Monash-BoSL/microBoSL/README.md

# microBoSL
This is a repository for the microBoSL motor controller
