Monash-BoSL/microBoSL/Design/RTC Resistor Supply Calulations.xlsx

V | 10 | 7.2 | 8.4
R1 | 4700000
R2 | 4700000 | RRTCnx | IRTC
RRTC | 2819075.403 | 3816758.102 | 9.672909972e-07
I | 1.547475276e-06 | A
VRTC | 2.726866202 | V
IRTC | 9.672909777e-07 | A
V | I | VRTC | IRTC
6 | 9.44737906e-07 | 1.559731842 | 6.128800673e-07
6.5 | 1.002218166e-06 | 1.789574621 | 6.214576082e-07
7 | 1.065080968e-06 | 1.994119452 | 6.40800233e-07
7.5 | 1.132012105e-06 | 2.179543109 | 6.682795283e-07
8 | 1.202206286e-06 | 2.349630456 | 7.022849123e-07
8.5 | 1.275118562e-06 | 2.506942757 | 7.417264865e-07
9 | 1.350353023e-06 | 2.653340792 | 7.858124291e-07
9.5 | 1.427606772e-06 | 2.790248174 | 8.339369474e-07
10 | 1.515892943e-06 | 2.875303169 | 9.041263109e-07
