Monash-BoSL/microBoSL/EDA/microBoSL BOM rev 0.3.0R.xlsx

Part Number | Package Size / Type | Schematic Designator | Component | Notes | Value | QTY per board | Unit Price | Total Price | Supplier
CL21A225KAFNNNE | `0850 | C1 | SMD Capacitor |  | 2.2 µF | 1 |  |  | https://au.mouser.com/ProductDetail/Samsung-Electro-Mechanics/CL21A225KAFNNNE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
C0402C220J8HACTU | `0402 | C2, C3 | SMD Capacitor |  | 22 pF | 2 |  |  | https://au.mouser.com/ProductDetail/KEMET/C0402C220J8HACTU?qs=W0yvOO0ixfGTPsKyhb5TPg%3D%3D
C0402C103K3RACTU | `0402 | C4, C5, C6, C7, C9, C16 | SMD Capacitor |  | 100 nF | 6 |  |  | https://au.mouser.com/ProductDetail/KEMET/C0402C103K3RACTU?qs=A9KPa1hU2BRD%252BYWIRO5N9g%3D%3D
C0402C101K3RACAUTO | `0402 | C8 | SMD Capacitor |  | 100 pF | 1 |  |  | https://au.mouser.com/ProductDetail/KEMET/C0402C101K3RACAUTO?qs=DuoOggApuK%2FQ6tIpLsntww%3D%3D
CBR04C519C5GAC | `0402 | C10, C12 | SMD Capacitor |  | 5.1 pF | 2 |  |  | https://au.mouser.com/ProductDetail/KEMET/CBR04C519C5GAC?qs=3SGS%2FGl3GGyNP7GoYF0kaA%3D%3D
C0402C689C5HACTU | `0402 | C11 | SMD Capacitor |  | 6.8 pF | 1 |  |  | https://au.mouser.com/ProductDetail/KEMET/C0402C689C5HACTU?qs=W0yvOO0ixfGXwgbtOD1z1Q%3D%3D
C0402C120J5HACTU | `0402 | C13 | SMD Capacitor |  | 12 pF | 1 |  |  | https://au.mouser.com/ProductDetail/KEMET/C0402C120J5HACTU?qs=W0yvOO0ixfEXT14Jx8aNmg%3D%3D
C0402C180J5GAC | `0402 | C14 | SMD Capacitor |  | 18 pF | 1 |  |  | https://au.mouser.com/ProductDetail/KEMET/C0402C180J5GAC?qs=cr8T4Ugre44OlnkcWxtp5A%3D%3D
CBR04C919B5GAC | `0402 | C15 | SMD Capacitor |  | 9.1 pF | 1 |  |  | https://au.mouser.com/ProductDetail/KEMET/CBR04C919B5GAC?qs=bKFmlxG1yYCTvjDGLjuaMw%3D%3D
C0402C150J4GACAUTO | `0402 | C17, C18 | SMD Capacitor |  | 15 pF | 2 |  |  | https://au.mouser.com/ProductDetail/KEMET/C0402C150J4GACAUTO?qs=hzBznG4dWXWlynvDG1YShw%3D%3D
150060RS55040 | `0603 | D1 | LED |  |  |  |  |  | https://au.mouser.com/ProductDetail/Wurth-Elektronik/150060RS55040?qs=8Aam6%252B7C6HHnMZFlrlTntA==
150060GS55040 | `0603 | D2 | LED |  |  |  |  |  | https://au.mouser.com/ProductDetail/Wurth-Elektronik/150060GS55040?qs=fAHHVMwC%252Bbhr5Aln2oA6Nw==
150060YS55040 | `0603 | D3 | LED |  |  |  |  |  | https://au.mouser.com/ProductDetail/Wurth-Elektronik/150060YS55040?qs=8Aam6%252B7C6HFRKfAQmHjhWw==
CUS08F30H3F | SOD-323 | D4 | Diode |  |  | 1 |  |  | https://au.mouser.com/ProductDetail/Toshiba/CUS08F30H3F
0685t1000-01 | `1206 | F1 | Fuse |  | 1A | 1 |  |  | https://au.element14.com/bel-fuse/0685t1000-01/fuse-smd-1a-slow-blow-1206/dp/2848605
105133-0001 |  | J8 | Micro USB Connectior |  |  | 1 |  |  | https://au.mouser.com/ProductDetail/Molex/105133-0001?qs=nmDtFRDcSi58kjLMHJLbzg==
7447840222G | `0402 | L1 | SMD Inductor |  | 220 nH | 1 |  |  | https://au.mouser.com/ProductDetail/Wurth-Elektronik/7447840222G?qs=aP1CjGhiNiGA2042fRI%2FsQ%3D%3D
`7847804680 | `0402 | L2 | SMD Inductor |  | 68 nH | 1 |  |  | https://au.mouser.com/ProductDetail/Wurth-Elektronik/7847804680?qs=QNEnbhJQKvb%252BwQpFKz64DQ%3D%3D
LQW15AN24NH00D | `0402 | L3 | SMD Inductor |  | 24 nH | 1 |  |  | https://au.mouser.com/ProductDetail/Murata-Electronics/LQW15AN24NH00D?qs=K6aI6PsrKE05Leu4Qv5MjA%3D%3D
`7847804270 | `0402 | L4 | SMD Inductor |  | 27 nH | 1 |  |  | https://au.mouser.com/ProductDetail/Wurth-Elektronik/7847804270?qs=QNEnbhJQKvaAR9QxS1FEoQ%3D%3D
7447840112G | `0402 | L5, L6 | SMD Inductor |  | 12 nH | 2 |  |  | https://au.mouser.com/ProductDetail/Wurth-Elektronik/7447840112G?qs=aP1CjGhiNiE%252BdejqttafAg%3D%3D
DMP2165UW-7 | SOT-323 | Q1, Q2 | MOSFET |  |  | 2 |  |  | https://au.mouser.com/ProductDetail/Diodes-Incorporated/DMP2165UW-7?qs=y6ZabgHbY%252ByvCNbAJzQtdQ==
ERJ-2RKF1002X | `0402 | R1, R2, R3, R5, R9, R10 | SMD Resistor |  | 10 kΩ | 6 |  |  | https://au.mouser.com/ProductDetail/Panasonic/ERJ-2RKF1002X?qs=sGAEpiMZZMvdGkrng054t8ugkoYZivkgyTBPpPnizTM%3D
CRCW04024M70FKEDC | `0402 | R4, R11, R12 | SMD Resistor |  | 4.7 MΩ | 3 |  |  | https://au.mouser.com/ProductDetail/Vishay-Dale/CRCW04024M70FKEDC
ERJ-2GEJ332X | `0402 | R6, R7, R8 | SMD Resistor |  | 3.3 kΩ | 3 |  |  | https://au.mouser.com/ProductDetail/Panasonic/ERJ-2GEJ332X?qs=sGAEpiMZZMvdGkrng054t8AJgcdMkx7xqgoPH9w2Bpk%3D
EG1215AA |  | SW2 | SPDT Switch |  | EG1215AA | 1 |  |  | https://www.digikey.com/en/products/detail/e-switch/EG1215AA/9559277
TPS709A33DBVT | SOT-323 | U1 | LDO |  | TPS709A33DBVT | 1 |  |  | https://au.mouser.com/ProductDetail/Texas-Instruments/TPS709A33DBVT?qs=9yI11AV48ZQgL37ZcAbPUA==
ZXBM5210-S-13 | SOIC-8 | U2 | H-Bridge |  | ZXBM5210-S | 1 |  |  | https://au.mouser.com/ProductDetail/Diodes-Incorporated/ZXBM5210-S-13?qs=98WN/nWUQiQlr91Z1/DTeg==
MCP7940NT-I-MNY | DFN-8 | U3 | RTC |  | MCP7940N-xMNY | 1 |  |  | https://au.mouser.com/ProductDetail/Microchip-Technology/MCP7940NT-I-MNY?qs=o%2FJGMiCJeCOibhksvba4EQ%3D%3D
ATMEGA328P-MMH | QFN-28 | U4 | MCU |  | ATmega328-MMH | 1 |  |  | https://au.mouser.com/ProductDetail/Microchip-Technology-Atmel/ATMEGA328P-MMH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
74HC126PW-Q100J | TSSOP-14 | U6 | Tri-state buffer |  | 74HC126PW-Q100 | 1 |  |  | https://au.mouser.com/ProductDetail/Nexperia/74HC126PW-Q100J
FT232RQ-REEL | QFN-32 | U7 | USB-TTL |  | FT232RQ | 1 |  |  | https://au.mouser.com/ProductDetail/FTDI/FT232RQ-REEL?qs=D1%2FPMqvA103VVcOzf7gfmQ%3D%3D
SI4463-C2A-GMR | QFN-20 | U8 | Radio |  | Si4463 | 1 |  |  | https://au.mouser.com/ProductDetail/Silicon-Labs/SI4463-C2A-GMR?qs=p9T7GgSe1IH7yXWv7w1wyw%3D%3D
520-80-18-33-JGN-TR3 |  | Y1 | Crystal |  | 8MHz | 1 |  |  | https://au.mouser.com/ProductDetail/ECS/ECS-80-18-33-JGN-TR3?qs=e8oIoAS2J1TSsZ53cMqlyQ%3D%3D
LFXTAL050789Reel |  | Y2 | Crystal |  | 32.768 kHz | 1 |  |  | https://au.mouser.com/ProductDetail/IQD/LFXTAL050789Reel
ABM8AIG-30.000MHz-12-D2Z-T |  | Y3 | Crystal |  | 30 MHz | 1 |  |  | https://au.mouser.com/ProductDetail/ABRACON/ABM8AIG-30.000MHz-12-D2Z-T?qs=0lSvoLzn4L93%2F944hWTYSg%3D%3D
