Monash-BoSL/microBoSL/EDA/microBoSL schematic rev 0.3.0R.pdf

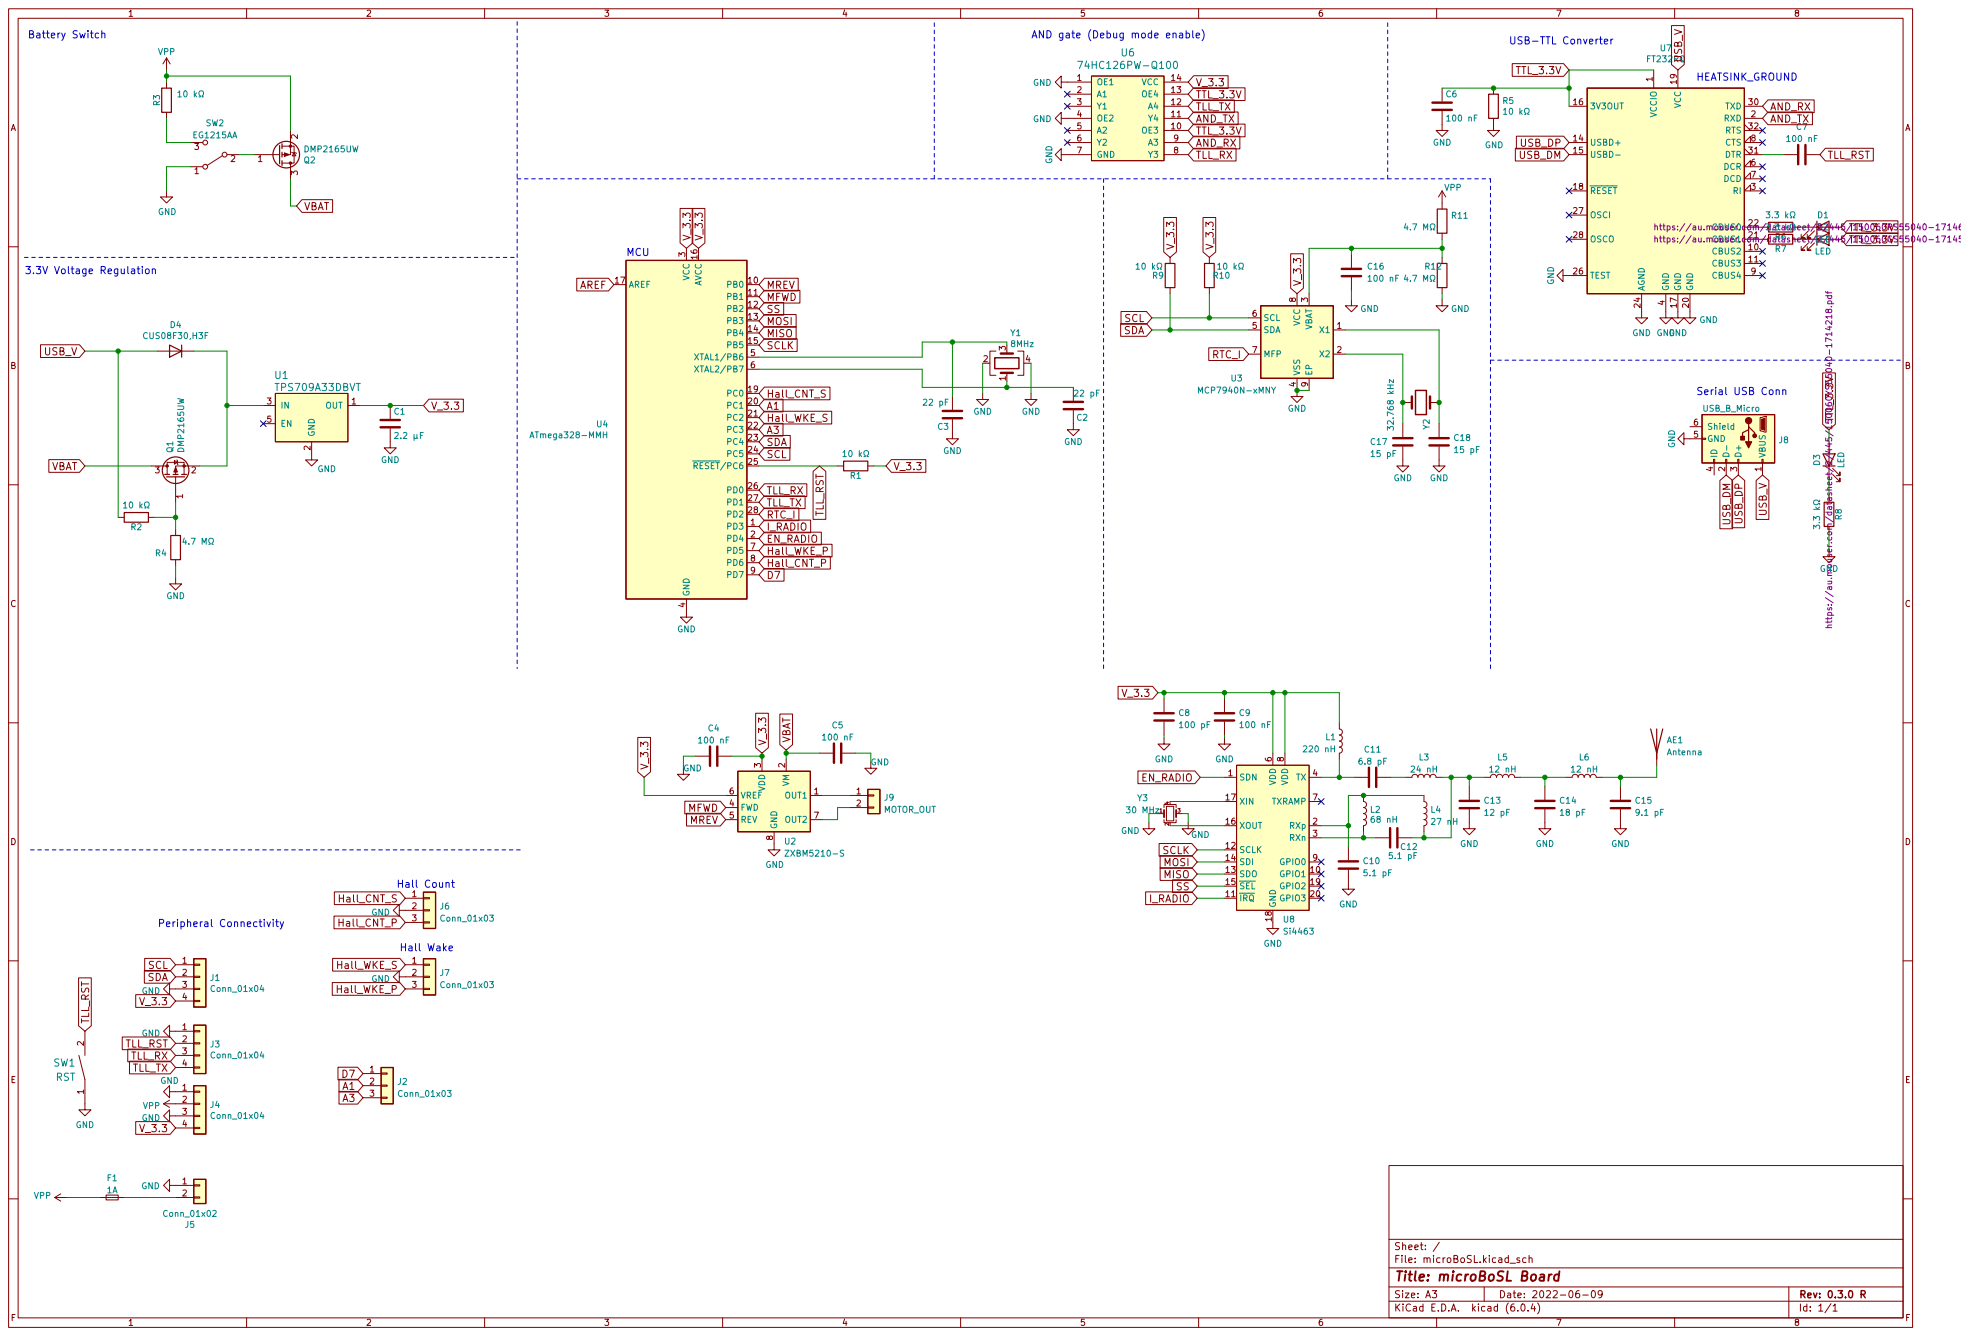
[picture p1: page 1]

https://au.mouser.com/datasheet/2/445/150060RS55040-1714619.pdf

21 CBUS0
https://au.mouser.com/datasheet/2/445/150060GS55040-1714515.pdf R6
10 CBUS3

4 SDA 5 SCL 6 MFP 7 VCC

3 FWD 4 REV 5 VREF 6 OUT2 7 GND

Hall Wake Peripheral Connectivity

Id: 1/1 Title: microBoSL Board
