Monash-BoSL/microBoSL/(list of files, drawings)

Other design files:
EDA/EDA/microBoSL.dsn
