Monash-BoSL/microBoSL/EDA/EDA/microBoSL.kicad_pcb

## KiCad design EDA/EDA/microBoSL.kicad_pcb (2022-06-20)

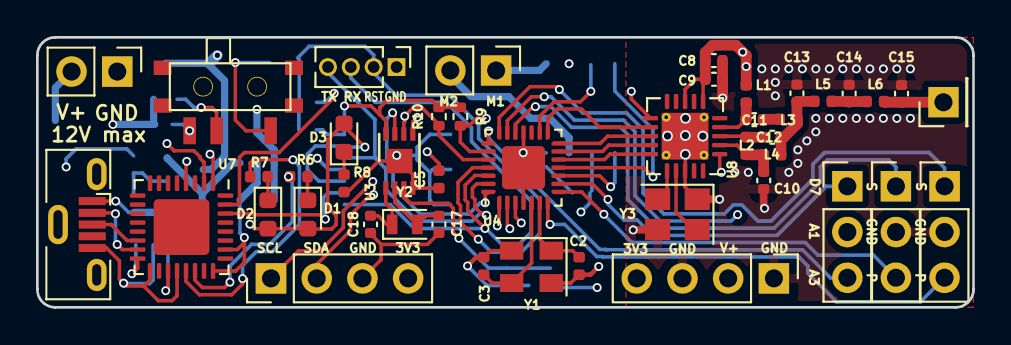
[picture p2: board microBoSL.kicad_pcb from above]

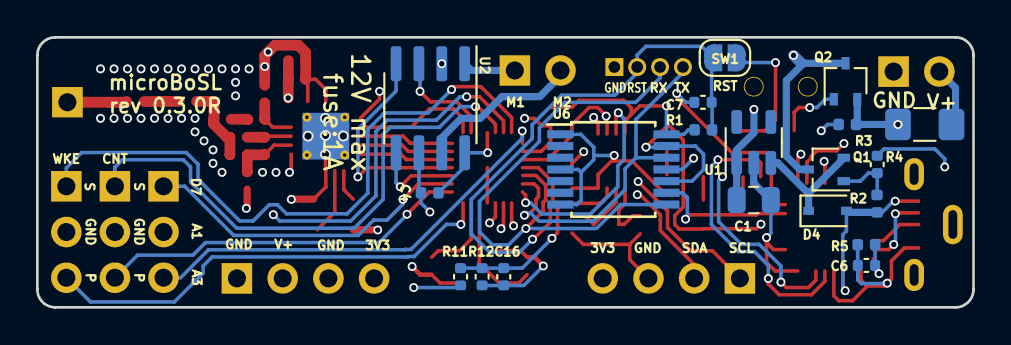
[picture p3: board microBoSL.kicad_pcb from below]

Board: 4 copper layers, 52.0 x 15.0 mm, 65 parts (20 on the bottom side), 58 nets.

Parts:
AE1: Antenna; PinHeader_1x01_P2.54mm_Vertical
C1: 2.2 μF; C_0805_2012Metric
C2, C3: 22 pF; C_0402_1005Metric
C4, C5, C6, C7, C9, C16: 100 nF; C_0402_1005Metric
C8: 100 pF; C_0402_1005Metric
C10, C12: 5.1 pF; C_0402_1005Metric
C11: 6.8 pF; C_0402_1005Metric
C13: 12 pF; C_0402_1005Metric
C14: 18 pF; C_0402_1005Metric
C15: 9.1 pF; C_0402_1005Metric
C17, C18: 15 pF; C_0402_1005Metric
D1, D2, D3: LED; LED_0603_1608Metric
D4: CUS08F30,H3F; D_SOD-323
F1: 1A; Fuse_1206_3216Metric_Pad1.42x1.75mm_HandSolder
J1, J4: Conn_01x04; PinHeader_1x04_P2.54mm_Vertical
J2, J6, J7: Conn_01x03; PinHeader_1x03_P2.54mm_Vertical
J3: Conn_01x04; PinHeader_1x04_P1.27mm_Vertical
J5: Conn_01x02; PinHeader_1x02_P2.54mm_Vertical
J8: USB_B_Micro; USB_Micro-B_Molex-105133-0001
J9: MOTOR_OUT; PinHeader_1x02_P2.54mm_Vertical
L1: 220 nH; L_0402_1005Metric
L2: 68 nH; L_0402_1005Metric
L3: 24 nH; L_0402_1005Metric
L4: 27 nH; L_0402_1005Metric
L5, L6: 12 nH; L_0402_1005Metric
Q1, Q2: DMP2165UW; SOT-323_SC-70
R1, R2, R3, R5, R9, R10: 10 kΩ; R_0402_1005Metric
R4, R11, R12: 4.7 MΩ; C_0402_1005Metric
R6, R7, R8: 3.3 kΩ; R_0402_1005Metric
SW1: RST; SolderJumper-2_P1.3mm_Open_RoundedPad1.0x1.5mm
SW2: EG1215AA
U1: TPS709A33DBVT; SOT-23-5
U2: ZXBM5210-S; SOIC-8_3.9x4.9mm_P1.27mm
U3: MCP7940N-xMNY; DFN-8-1EP_3x2mm_P0.5mm_EP1.36x1.46mm
U4: ATmega328-MMH; QFN-28-1EP_4x4mm_P0.45mm_EP2.4x2.4mm
U6: 74HC126PW-Q100; TSSOP-14_4.4x5mm_P0.65mm
U7: FT232RQ; QFN-32-1EP_5x5mm_P0.5mm_EP3.1x3.1mm
U8: Si4463; QFN-20-1EP_4x4mm_P0.5mm_EP2.6x2.6mm_ThermalVias
Y1: 8MHz; Crystal_SMD_EuroQuartz_MT-4Pin_3.2x2.5mm
Y2: 32.768 kHz; Crystal_SMD_2012-2Pin_2.0x1.2mm
Y3: 30 MHz; Crystal_SMD_Abracon_ABM8G-4Pin_3.2x2.5mm

Connections:
A1: J2.2, U4.20 (PC1)
A3: J2.3, U4.22 (PC3)
AND_RX: U6.9 (A3), U7.30 (TXD)
AND_TX: U6.11 (Y4), U7.2 (RXD)
D7: J2.1, U4.9 (PD7)
EN_RADIO: U4.2 (PD4), U8.1 (SDN)
GND: C1.2, C2.1, C3.1, C4.1, C5.2, C6.2, C8.2, C9.2, C10.2, C13.2, C14.2, C15.2, C16.2, C17.1, C18.1, J1.3, J3.1, J4.1, J4.3, J5.1, J6.2, J7.2, J8.5 (GND), R4.1, R5.2, R8.2, R12.2, SW1.1, SW2.1 (A), U1.2 (GND), U2.8 (GND), U3.4 (VSS), U3.9 (EP), U4.4 (GND), U4.18 (GND), U4.29 (GND), U6.1 (OE1), U6.4 (OE2), U6.7 (GND), U7.4 (GND), U7.17 (GND), U7.20 (GND), U7.24 (AGND), U7.26 (TEST), U8.18 (GND), U8.21 (GND), Y1.2, Y1.4, Y3.1, Y3.3
Hall_CNT_P: J6.3, U4.8 (PD6)
Hall_CNT_S: J6.1, U4.19 (PC0)
Hall_WKE_P: J7.3, U4.7 (PD5)
Hall_WKE_S: J7.1, U4.21 (PC2)
I_RADIO: U4.1 (PD3), U8.11 (~IRQ)
MFWD: U2.4 (FWD), U4.11 (PB1)
MISO: U4.14 (PB4), U8.13 (SDO)
MOSI: U4.13 (PB3), U8.14 (SDI)
MREV: U2.5 (REV), U4.10 (PB0)
unnamed: AE1.1 (A), C15.1, L6.2
unnamed: C2.2, U4.6 (XTAL2/PB7), Y1.1
unnamed: C3.2, U4.5 (XTAL1/PB6), Y1.3
unnamed: C7.2, U7.31 (DTR)
unnamed: C10.1, L2.1, L4.1, U8.2 (RXp)
unnamed: C11.1, L3.1
unnamed: C11.2, L1.2, U8.4 (TX)
unnamed: C12.1, C13.1, L3.2, L4.2, L5.1
unnamed: C12.2, L2.2, U8.3 (RXn)
unnamed: C14.1, L5.2, L6.1
unnamed: C16.1, R11.2, R12.1, U3.3 (VBAT)
unnamed: C17.2, U3.2 (X2), Y2.2
unnamed: C18.2, U3.1 (X1), Y2.1
unnamed: D1.1 (K), R6.1
unnamed: D2.1 (K), R7.1
unnamed: D3.1 (K), R8.1
unnamed: D4.1 (K), Q1.2 (S), U1.3 (IN)
unnamed: F1.2, J5.2
unnamed: J9.1, U2.1 (OUT1)
unnamed: J9.2, U2.7 (OUT2)
unnamed: Q1.1 (G), R2.1, R4.2
unnamed: Q2.1 (G), SW2.2 (B)
unnamed: R3.1, SW2.3 (C)
unnamed: R6.2, U7.22 (CBUS0)
unnamed: R7.2, U7.21 (CBUS1)
unnamed: U8.16 (XOUT), Y3.2
unnamed: U8.17 (XIN), Y3.4
RTC_I: U3.7 (MFP), U4.28 (PD2)
SCL: J1.1, R10.1, U3.6 (SCL), U4.24 (PC5)
SCLK: U4.15 (PB5), U8.12 (SCLK)
SDA: J1.2, R9.2, U3.5 (SDA), U4.23 (PC4)
SS: U4.12 (PB2), U8.15 (~SEL)
TLL_RST: C7.1, J3.2, R1.2, SW1.2, U4.25 (~RESET/PC6)
TLL_RX: J3.3, U4.26 (PD0), U6.8 (Y3)
TLL_TX: J3.4, U4.27 (PD1), U6.12 (A4)
TTL_3.3V: C6.1, D1.2 (A), D2.2 (A), D3.2 (A), R5.1, U6.10 (OE3), U6.13 (OE4), U7.1 (VCCIO), U7.16 (3V3OUT)
USB_DM: J8.2 (D-), U7.15 (USBD-)
USB_DP: J8.3 (D+), U7.14 (USBD+)
USB_V: D4.2 (A), J8.1 (VBUS), R2.2, U7.19 (VCC)
VBAT: C5.1, Q1.3 (D), Q2.3 (D), U2.2 (VM)
VPP: F1.1, J4.2, Q2.2 (S), R3.2, R11.1
V_3.3: C1.1, C4.2, C8.1, C9.1, J1.4, J4.4, L1.1, R1.1, R9.1, R10.2, U1.1 (OUT), U2.3 (VDD), U2.6 (VREF), U3.8 (VCC), U4.3 (VCC), U4.16 (AVCC), U6.14 (VCC), U8.6 (VDD), U8.8 (VDD)
