Monash-BoSL/microBoSL/(commit log)

2021-06-24 initial commit of movement of microBoSL to indepedent repository
    [RTC Resistor Supply Calulations.xlsx, microBoSL BOM Rev 0.2.2.xlsx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]
2021-06-25 fixed o-ring circuit
    [microBoSL BOM Rev 0.2.2.xlsx, microBoSL BOM Rev 0.2.3.xlsx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]
2021-12-15 update of BOM
    [microBoSL BOM Rev 0.2.3.xlsx]
2022-05-17 updated kicad to rev 6.0
    [microBoSL.kicad_sch]
2022-05-17 rebase for adding wireless to microbosl
    [microBoSL BOM Rev 0.2.3.xlsx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]
2022-05-17 added Si4463 radio module
    [microBoSL.kicad_pcb, microBoSL.kicad_sch]
2022-05-17 moved location on pcb of si4463
    [microBoSL.kicad_pcb]
2022-06-09 finalised schematic for radio microbosl
    [microBoSL.kicad_sch]
2022-06-09 laying out pcb
    [microBoSL.kicad_pcb]
2022-06-09 more work on PCB layout
    [microBoSL.kicad_pcb]
2022-06-15 finished component placement
    [microBoSL.kicad_pcb]
2022-06-15 added BOM and finished most layout
    [microBoSL BOM rev 0.3.0R.xlsx, microBoSL.csv, microBoSL.kicad_pcb, microBoSL.kicad_sch]
2022-06-15 adding silkscreen
    [microBoSL.kicad_pcb]
2022-06-20 finished layout of pcb
    [microBoSL.kicad_pcb]
2022-06-20 microBoSL rev 0.3.0R release
    [microBoSL-B_Cu.gbl, microBoSL-B_Mask.gbs, microBoSL-B_SilkS.gbo, microBoSL-B_Silkscreen.gbo, microBoSL-Edge_Cuts.gm1, microBoSL-F_Cu.gtl, microBoSL-F_Mask.gts, microBoSL-F_SilkS.gto]
